levisawatz/Plasma_Flame_Radio/README.md

# Plasma_Flame_Radio

  This personal project was my first big step into RF circuits and pushed me to buy an oscilloscope and a vector network analyzer (VNA).  

## Part 1: Plasma Flame  
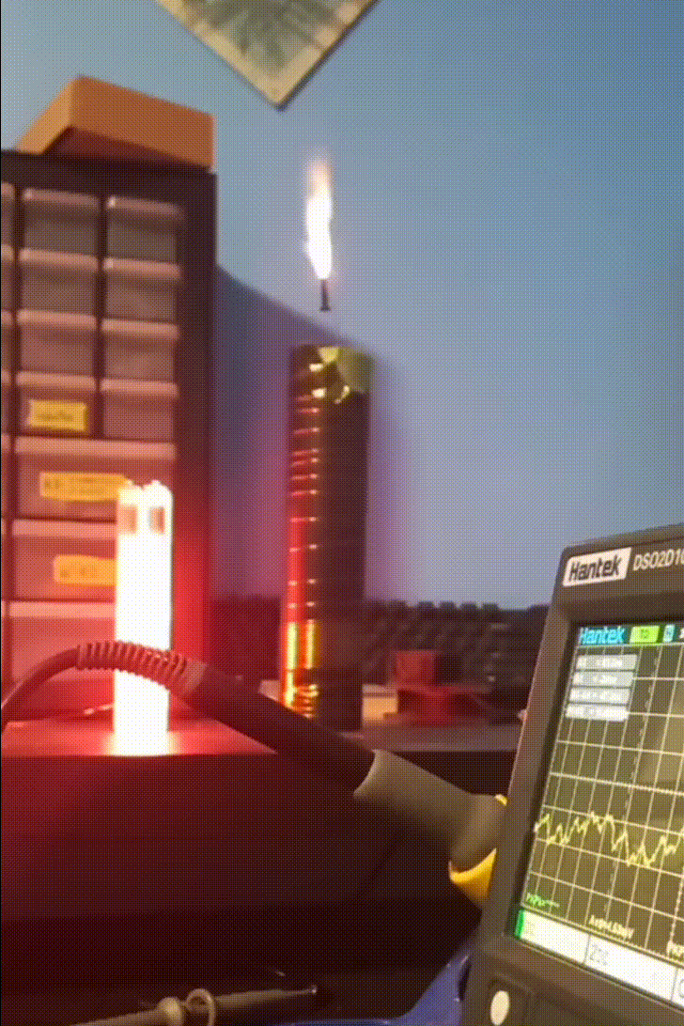
[picture p1: Media/massive_flame.gif]
  

This circuit pumps enough power into the antenna to rip apart air and create a "plasma flame". controlling the power of the flame with audio can turn it into a speaker! listen to the "singing flame" on my [linkedin_post](https://www.linkedin.com/posts/levi-sawatzky_pcbdesign-innovation-tech-activity-7251831981049618432-Eb7l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)

### Plasma flame circuit  
The main 10MHz oscillator uses a self resonant ZVS class E amplifier to drive the antenna.  
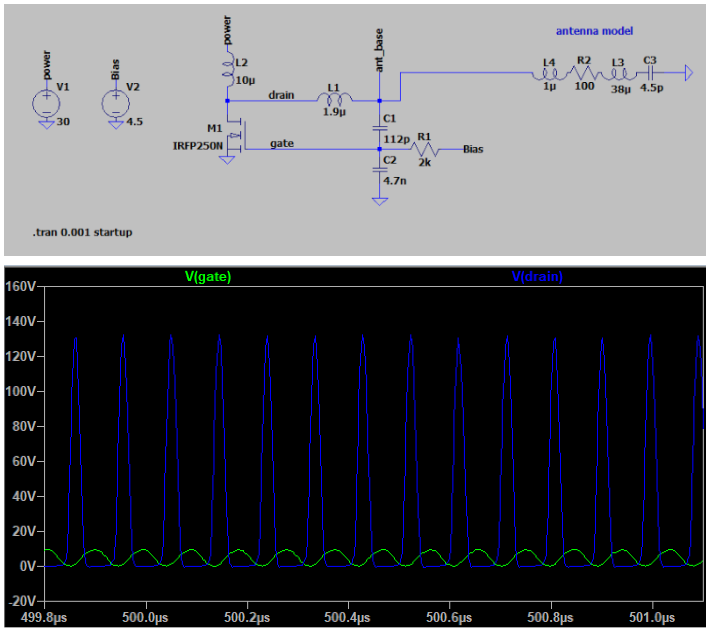
[picture p2: Media/flame_ltspice.png]

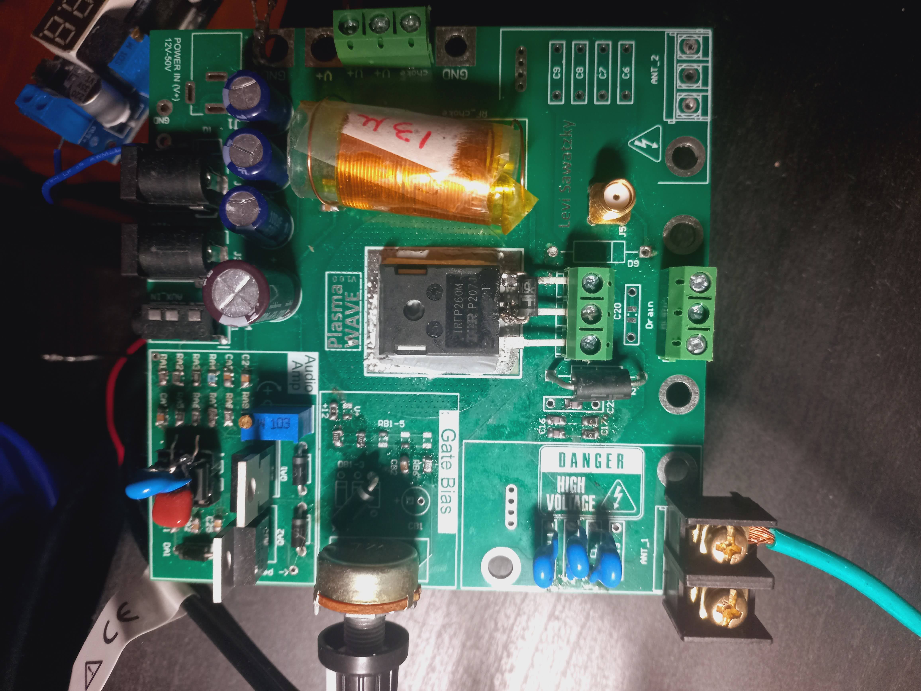
[picture p3: Media/V2 PCB.jpg]
  

## Part 2: 100W+ AM radio transmitter  

I modified the "plasma flame" circuit into an AM radio transmitter. This allowed me to transmit music as AM radio and listen to it using a handheld shortwave radio reciever.  

### AM radio circuit  
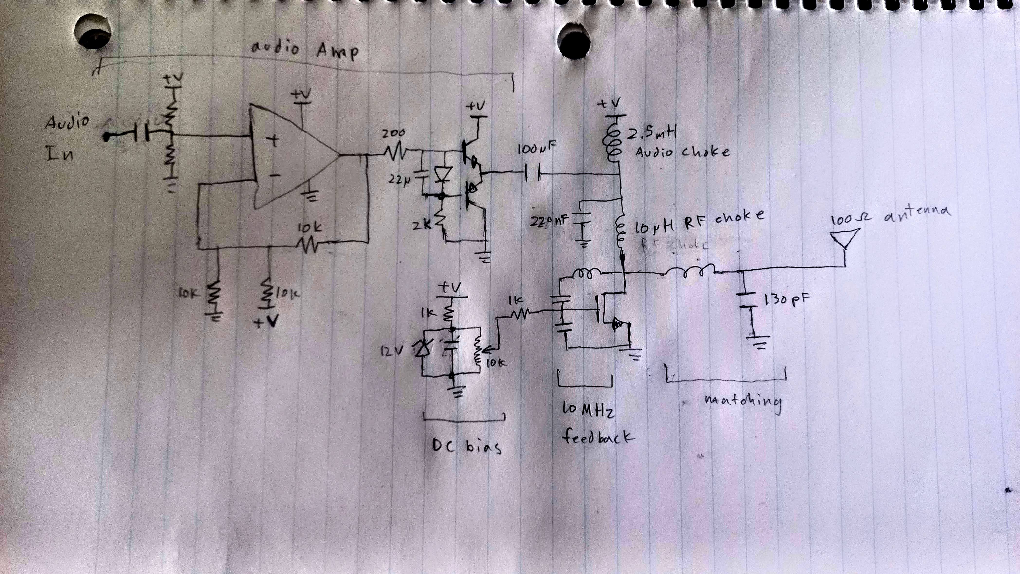
[picture p4: Media/circuit_diagram.jpg]
  

this circuit uses an audio amplifier to modulate the supply voltage to the RF amplifier. Below are measurements of the mosfet's drain as I feed a sine wave and a square wave into the "audio in" of the circuit. It shows the audio frequency signals modulated with the 10MHz carrier frequency.

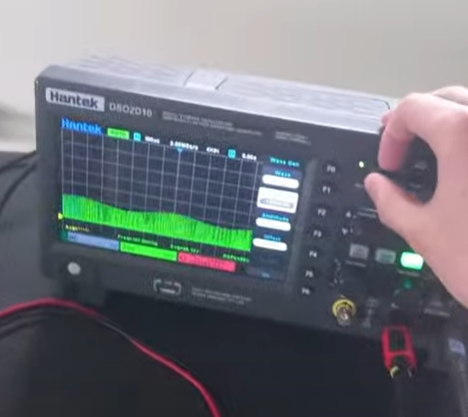
[picture p5: Media/AM sine.png]
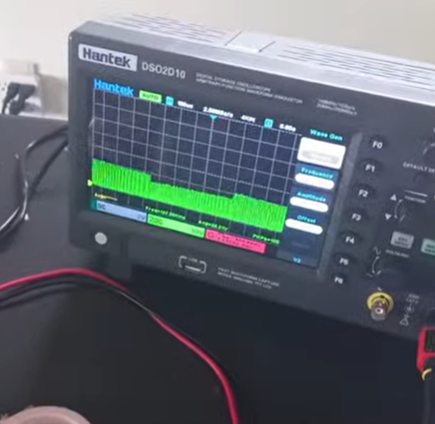
[picture p6: Media/AM square.png]
     

### Tuning the antenna  

The antenna is tuned and matched using a lumped network to allow for the ideal power to be transfered to the antenna. I learned so much about practical antennas during this project and the importance of effective grounding in sensitive circuits.  

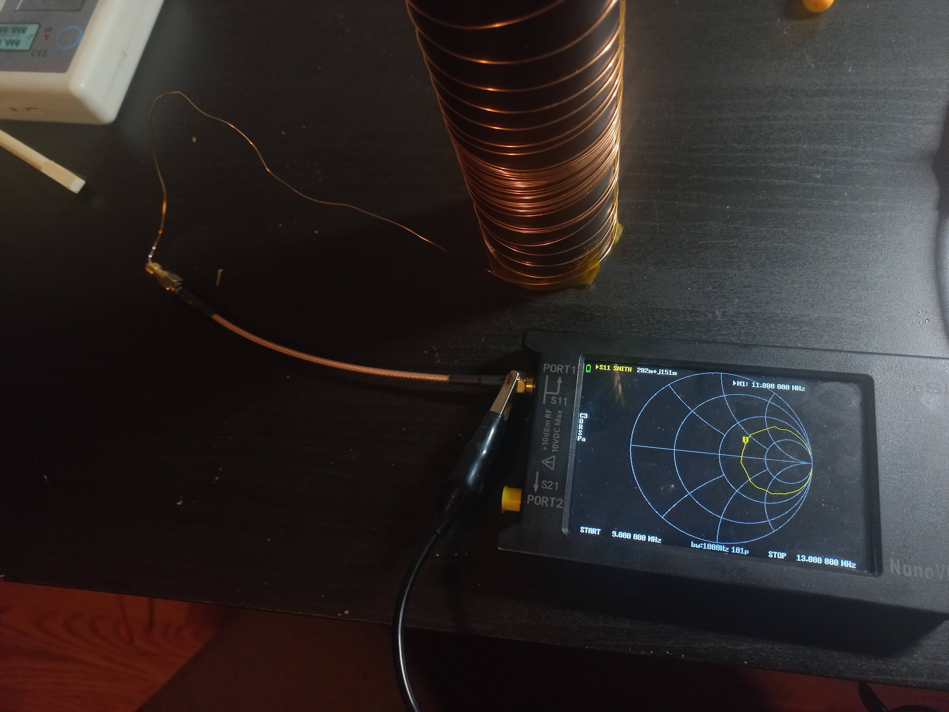
[picture p7: Media/plasma candle antenna vna.jpg]
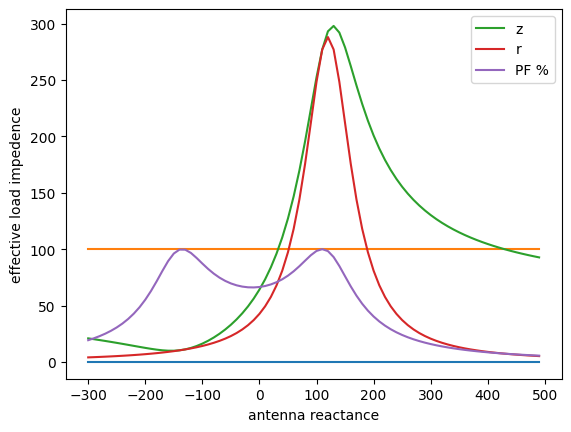
[picture p8: Media/antenna power sim.png]
      

A vector network analyzer made it possible analyze and simulate the antenna in order to calculate the bast values for the lumped network.

Class E amplifiers are notorious for creating unwanted harmonics. These harmonics are a waste of power and can cause interference in restricted frequency bands. I operated my radio at 10.12MHz to align with local radio laws and I mitigated emissions at the harmonic frequencies by ensuring that the load (antenna and matching network) had high impedence at the unwanted harmonic frequencies (especially 20.2MHz)  

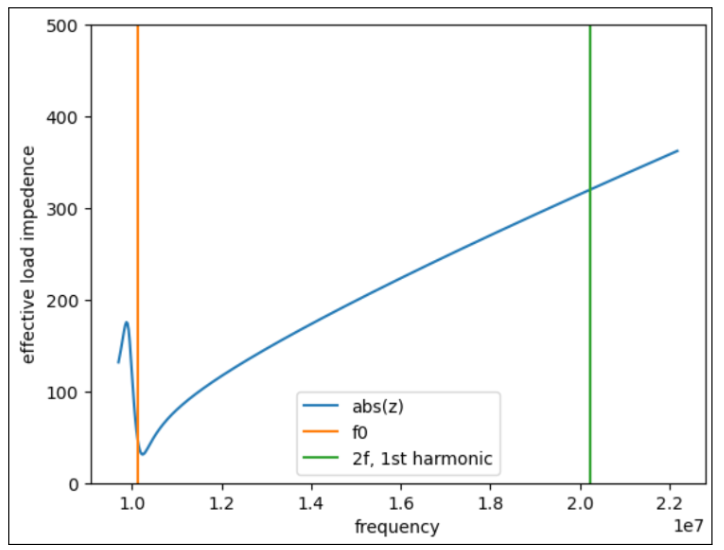
[picture p9: Media/impedence_vs_f.png]
