levisawatz/Plasma_Flame_Radio/Media/10MHz oscilator circuit.png

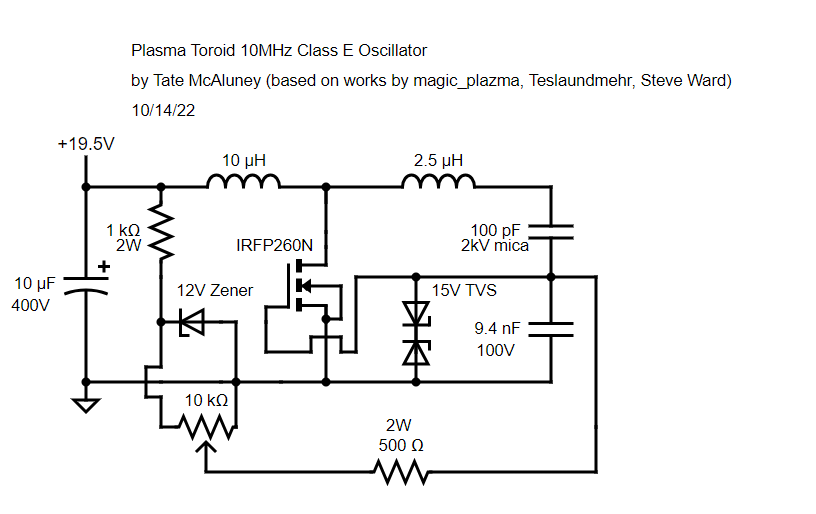
Media/10MHz oscilator circuit.png
