levisawatz/Plasma_Flame_Radio/Media/plasma candle yellow.png

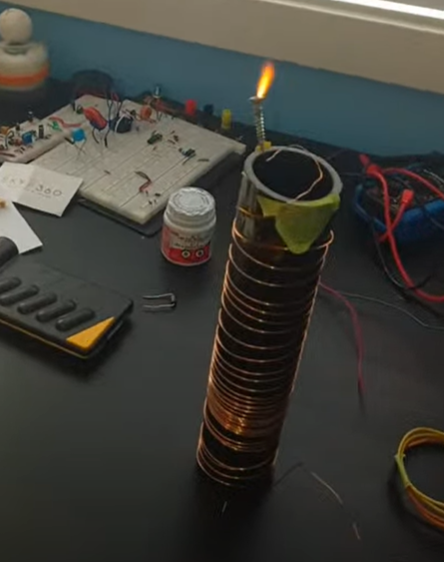
Media/plasma candle yellow.png
