levisawatz/Plasma_Flame_Radio/Media/plasma candle.png

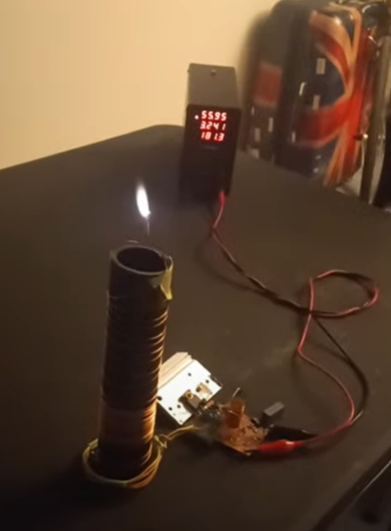
Media/plasma candle.png
