levisawatz/Plasma_Flame_Radio/simulations/LTspice/Screenshot 2024-09-14 101546.png

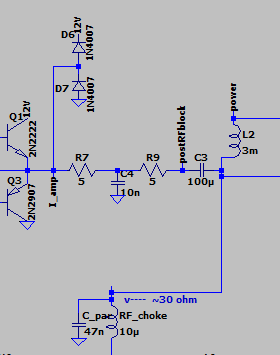
simulations/LTspice/Screenshot 2024-09-14 101546.png
