levisawatz/Plasma_Flame_Radio/simulations/LTspice/Draft3.asc

C1: cap; 200µ
C2: cap; 5µ
D1: diode
D2: diode
I1: load2; PULSE(0 5 0 20 .01 .01 24)
L1: ind; 2m
R1: res; 10k
V1: voltage; SINE(0 30 60)
Named nets: 0
.tran 20
