levisawatz/Plasma_Flame_Radio/simulations/LTspice/FBR.asc

C1: cap; 10µ
D1: diode
D3: diode
D4: diode
R1: res; 1000
R2: res; 10000
V1: voltage; SINE(0 160 60)
Named nets: V+, 0
.tran 3
