levisawatz/Plasma_Flame_Radio/simulations/LTspice/HBR.asc

C1: cap; 2436µ
C2: cap; 5µ
D1: diode
D2: diode
I1: load2; PULSE(0 10 0 20 .01 .01 24)
L1: ind; 2m
R1: res; 10k
V1: voltage; SINE(0 100 60 0 0 1)
Named nets: 0
.tran 20
