levisawatz/Plasma_Flame_Radio/simulations/LTspice/Mhz10-Plasma_flame_ex1.asc

C1: cap; 100p; Rser=.01
C2: cap; 5n; Rser=.1
C3: cap; 4.5p
C4: cap; 20p
C5: cap; 80p
L1: ind; 2.65µ; Rser=150m
L2: ind; 13µ; Rser=50m
L3: ind; 52µ
L4: ind; 0.421µ
L5: ind; 2n; Rser=1m
L6: ind; 10n; Rser=1m
L7: ind; 3n
L8: ind; 3n
L9: ind; 8n
L10: ind; 3n
L11: ind; 8n
L12: ind; 3n
L13: ind; 3n; Rser=50m
M1: nmos; SPA11N60C3
R1: res; 1k
R2: res; 100
V1: voltage; 25; Rser=.2
V2: voltage; 5.8
Named nets: power, 0, Bias, ant_base, gate, drain
.tran 0.001 startup
antenna model
drain TVS
