levisawatz/Plasma_Flame_Radio/simulations/LTspice/AMhz10-radio.asc

C1: cap; 100p; Rser=1m
C2: cap; 4.7n; Rser=1m
C3: cap; 100µ; Rser=.15
C4: cap; 10n
C5: cap; 10µ
C_ant: cap; 4.5p
C_par: cap; 47n
c_t: cap; 130p
D1: diode; 1N4007
D2: zener; UFZV6_2B
D3: diode; 1N4007
D4: zener; UFZV6_2B
D5: diode; 1N4007
D6: diode; 1N4007
D7: diode; 1N4007
D9: diode; 1N4007
D12: diode; 1N4007
L1: ind; 2.65µ; Rser=150m
L2: ind; 3m; Rser=.5
L3: ind; 1n; Rser=1m
L_ant: ind; 55µ
L_m: ind; 1.25µ
L_short: ind; -3.15µ
M1: nmos; IRFP90N20D
Q1: npn; 2N2222
Q3: pnp; 2N2907
R1: res; 1k
R2: res; 10k
R4: res; 10k
R5: res; 10k
R6: res; 1k
R7: res; 2
R9: res; 2
R_ant: res; 100
RF_choke: ind; 10µ; Rser=10m
U1: OP07
V1: voltage; 35
V2: voltage; 5; Rser=.1 Cpar=100u
V3: voltage; PULSE(5 7 0 1u 1u .5m 1m); AC 1
V4: voltage; 12V
Named nets: 0, Bias, gate, ant_base, drain, 12V, power, Audio, opamp_out, I_amp, ckokes, postRFblock
.tran 0 0.01 0
Cout: 152pF
v----  ~30 ohm
.ac oct 500 10 40000
.ic V(postRFblock)=6
.ic V(ckokes)=35
.ic I(L2)=3
