levisawatz/Plasma_Flame_Radio/simulations/LTspice/Draft1.asc

C1: cap; 1m
C2: cap; 100µ
C3: cap; 10µ
D1: zener; TFZV7_5B
M1: nmos; IRFP250N
M2: pmos; IRFP9240
R1: res; 10k
R2: res; 10
R3: res; 10k
R4: res; 1
R5: res; 1
V1: voltage; SINE(15 10 10000)
V2: voltage; PULSE(0 30 0 .01 .001 0 .011)
V3: voltage; 30
Named nets: 0
.tran 0 10 0
.ic V(n005)=15
.ic V(n003)=3
