levisawatz/Plasma_Flame_Radio/simulations/LTspice/Draft2.asc

C1: cap; 4.7n; Rser=.01
C2: cap; 10
C3: cap; 600p
C4: cap; 4.5p
C5: cap; 130p; Rser=.01
L1: ind; 25n; Rser=.02
L2: ind; 10n
L3: ind; 1; Rser=10000
L4: ind; 52µ
L5: ind; 1µ
L6: ind; 2µ; Rser=150m
M1: nmos; IRFP250N
R1: res; 100
R2: res; 10k
V1: voltage; ""; AC 1 0
V2: voltage; 10
Named nets: 0
.ac oct 200 100k 200000000
