levisawatz/Plasma_Flame_Radio/simulations/LTspice/Mhz10-Plasma_flame_bad_diode.asc

C1: cap; 100p; Rser=.01
C2: cap; 4.7n; Rser=.1
C3: cap; 4.5p
C5: cap; 80p
L1: ind; 2.65µ; Rser=150m
L2: ind; 13µ; Rser=50m
L3: ind; 52µ
L4: ind; 1µ
L5: ind; 2n; Rser=1m
L7: ind; 3n
L8: ind; 3n
L12: ind; 3n
L_lead_D: ind; 8n
L_lead_G: ind; 8n
L_lead_S: ind; 8n
M1: nmos; IRFP250N
R1: res; 1k
R2: res; 100
V1: voltage; 24; Rser=.2
V2: voltage; 5.
Named nets: power, 0, Bias, ant_base, gate, drain, real_gate, real_drain, real_source
antenna model
.tran 10m startup
