levisawatz/Plasma_Flame_Radio/simulations/LTspice/AMhz10-radio-gate_modulation.asc

C1: cap; 100p; Rser=.01
C2: cap; 4.7n; Rser=.01
C3: cap; 17p
C4: cap; 100µ
C5: cap; 10n
C6: cap; 99p; Rser=.01
L1: ind; 2.69µ
L2: ind; 10µ
L4: ind; 14.56µ
L5: ind; 330µ; Rser=100
L7: ind; .709µ
M1: nmos; IRFP250N
R1: res; 7k
R2: res; 100
R3: res; 5k
R4: res; 100
S1: sw
V1: voltage; 30
V2: voltage; 4.8; Rser=.1 Cpar=1u
V3: voltage; SINE(4.8 1.5 10k)
V4: voltage; PULSE(0 5 .3m .1u 0.5 5)
Named nets: power, 0, Bias, gate, ant_base, drain
.tran 0 0.001 0.0002 startup
Cout: 152pF
