levisawatz/Plasma_Flame_Radio/simulations/LTspice/AMhz10-radio-transformer_choke.asc

C1: cap; 100p
C2: cap; 4.7n; Rser=.01
C4: cap; 10000µ
C5: cap; 10n
C6: cap; 47n
C_ant: cap; 17p
c_t: cap; 133p
L1: ind; 2.65µ
L2: ind2; 2m
L3: ind2; 2m
L4: ind; 10µ
L5: ind; 30µ; Rser=100
L_ant: ind; 14.56µ
L_m: ind; 2.937µ
L_short: ind; 3.145µ
M1: nmos; IRFP250N
R1: res; 2k
R3: res; 10
R4: res; 1
R_ant: res; 100
S1: sw
V1: voltage; 30
V2: voltage; 4.5; Rser=.1 Cpar=100u
V3: voltage; SINE(0 10 10k)
V4: voltage; PULSE(0 5 .3m .1u 0.5 5)
Named nets: power, 0, Bias, gate, ant_base, drain
.tran 0 0.001 0.0002 startup
Cout: 152pF
K1 L2 L3 -1
v----  ~30 ohm
