levisawatz/Plasma_Flame_Radio/simulations/LTspice/Mhz10-Plasma_flame.asc

C1: cap; 112p; Rser=.01
C2: cap; 4.7n; Rser=.01
C3: cap; 4.5p
L1: ind; 1.9µ
L2: ind; 10µ
L3: ind; 38µ
L4: ind; 1µ
M1: nmos; IRFP250N
R1: res; 2k
R2: res; 100
V1: voltage; 30
V2: voltage; 4.5
Named nets: power, 0, Bias, ant_base, gate, drain
.tran 0.001 startup
antenna model
